bigcrimping/cistercian_clock/README.md

# Cistercian Clock

github

I keep a list of project ideas I want to do, and fairly near the top it says "NEW CLOCK".
After reading about [Cistercian Numerals](https://en.wikipedia.org/wiki/Cistercian_numerals) I decided to make a clock which:

1) Shows the date and time in the least amount of digits
2) Acts as a way of training my brain to do repetitive maths (something I don't enjoy)

Watch on YouTube (https://youtu.be/COuOULkGAXk)

The design is a custom PCB based on a ESP32 and MAX6969 LED drivers in a 3D printed housing

# How to read the time

The Cistercian Numeral system uses one digit to be able to count up to 9999

cistercian

The clock has two digits, left and right. The goal was to use as much of the range of each digit as possible.

The right hand digit is counting up in seconds until it reaches 7200 which is 2 hours.

The left hand digit is counting up in 2 hour increments, 4380 sets of 2 hours in a year.

# Software Setup

To setup the ESP32, load MicroPython from https://micropython.org/download/

Copy `code/secrets.example.py` to `code/secrets.py` and fill in your WiFi details. `secrets.py` is gitignored so your password won't be committed.

Once loaded, put the `main.py` and `secrets.py` into the MicroPython environment.

You can change your timezone in the main.py using `TIMEZONE_OFFSET` (hours from UTC, e.g. `1` for CET or `5.5` for IST)

The clock re-syncs with NTP once a day, and if WiFi isn't available at power-up it keeps retrying every 5 minutes.

# Mechanical Build

To assemble the clock first put the button into the rear housing

1_button_in

Then insert the PCB into the rear housing

2_pcb_in

Insert the light guide and diffuser

3_front_panels

Attach with M2 screws

4_screws

# PCB Build

The PCB is a simple double-sided board. The Gerbers are in the relevant folder and should be easy to produce by any PCB vendor.
