bigcrimping/cistercian_clock/mech/back_body.3MF

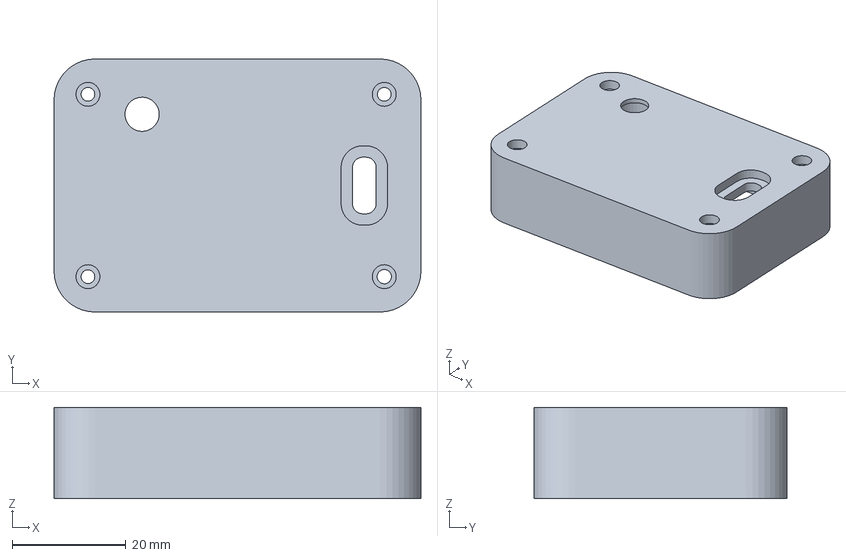
[picture p1: CAD file, 2026-03-03]
mech/back_body.3MF
64.4 x 44.4 x 16.0 mm
