bigcrimping/cistercian_clock/mech/button.3MF

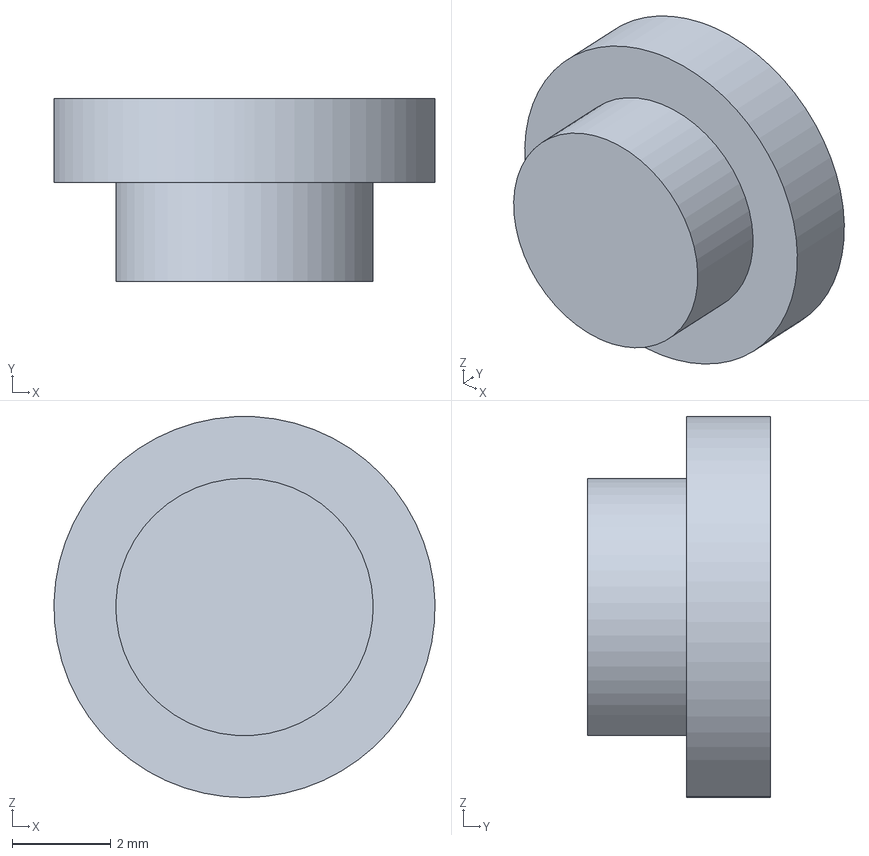
[picture p2: CAD file, 2026-03-03]
mech/button.3MF
7.70 x 3.70 x 7.70 mm
