bigcrimping/cistercian_clock/mech/light_guide.3MF

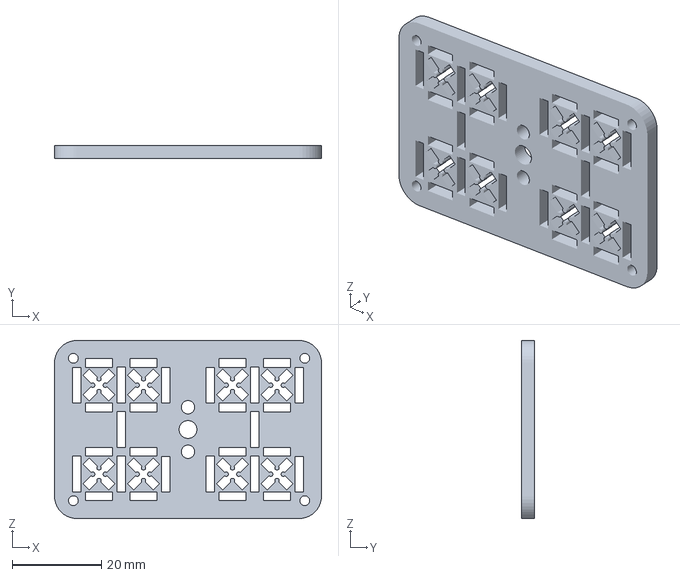
[picture p3: CAD file, 2026-03-03]
mech/light_guide.3MF
60.0 x 3.00 x 40.0 mm
