bigcrimping/cistercian_clock/mech/front_panel.3MF

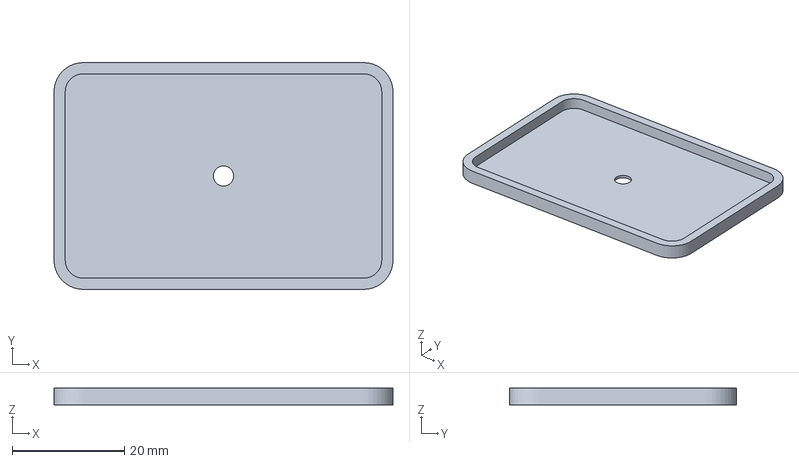
[picture p4: CAD file, 2026-03-03]
mech/front_panel.3MF
60.4 x 40.4 x 3.00 mm
