bigcrimping/cistercian_clock/pcb/assembly.pdf

DS53

DS31

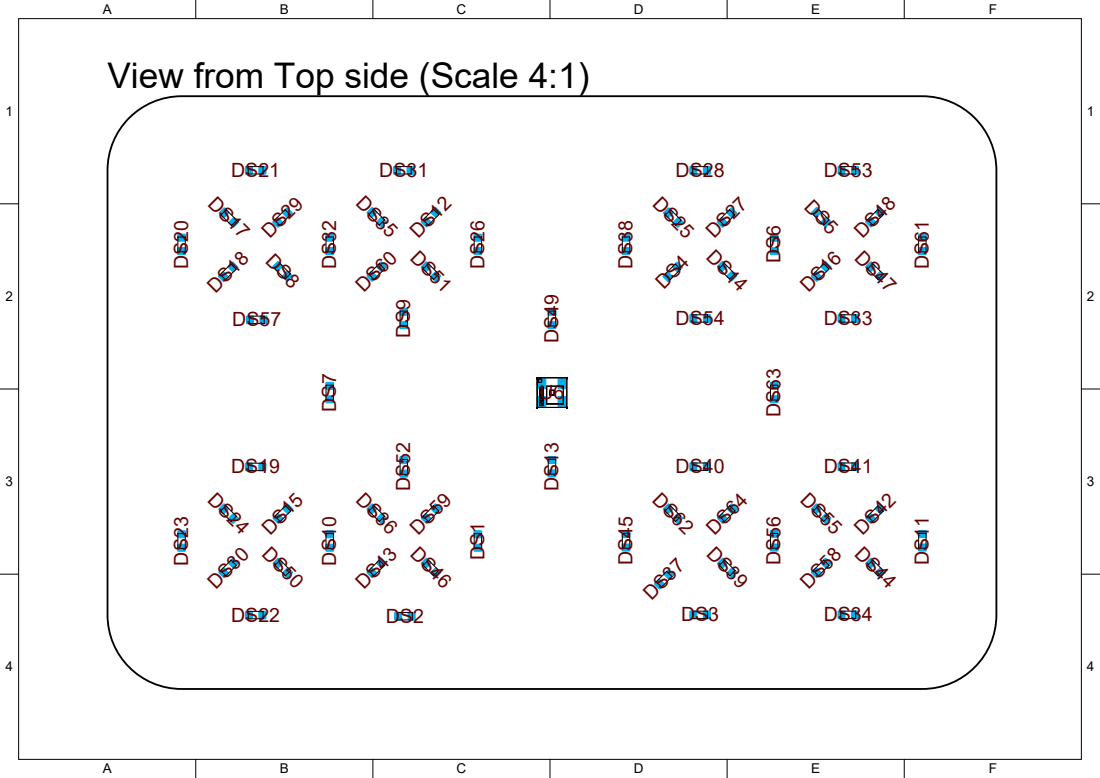
[picture p5: page 1]
DS3 DS¹

View from Top side (Scale 4:1)

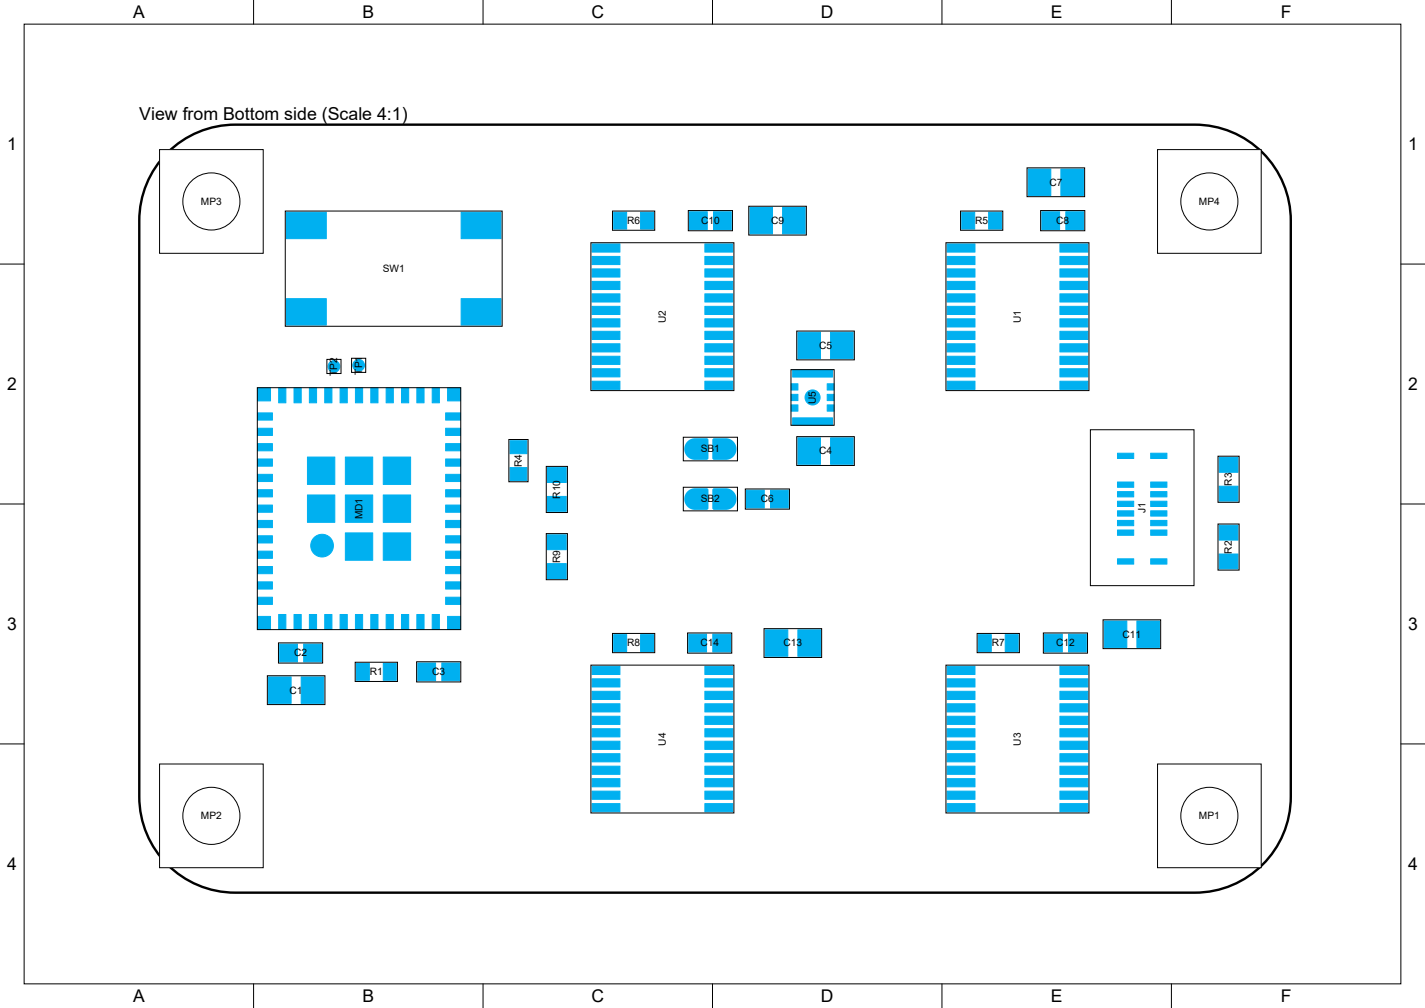
[picture p6: page 2]

View from Bottom side (Scale 4:1)

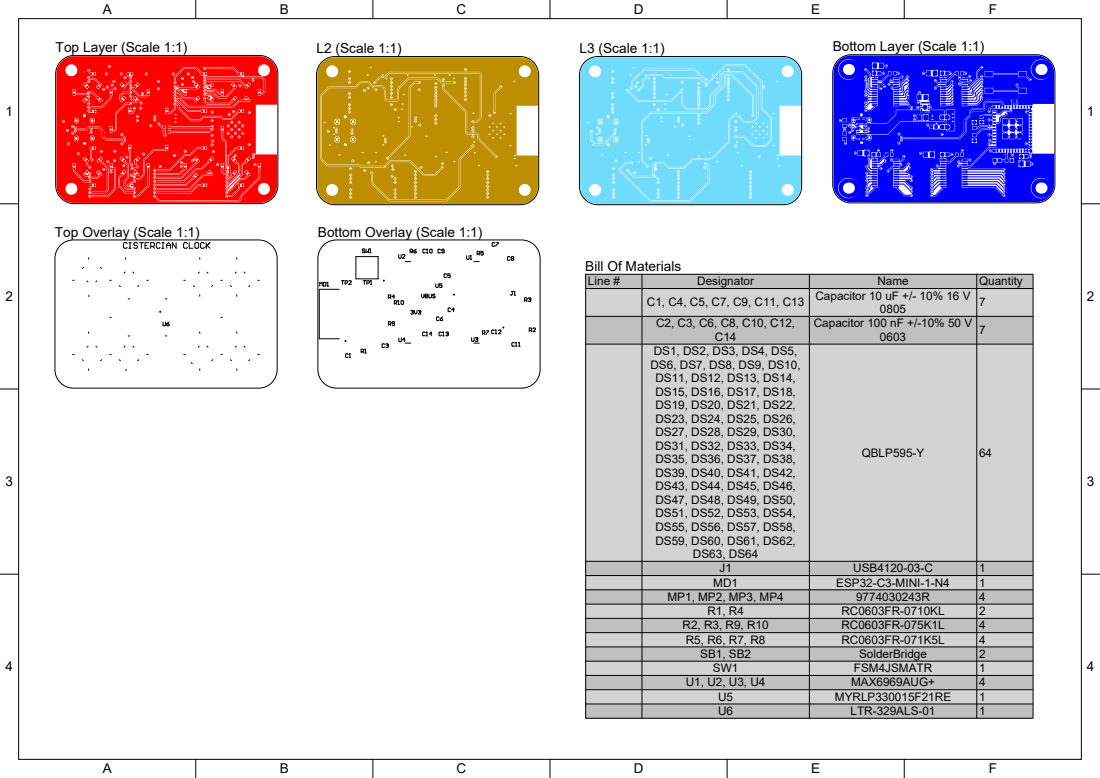
[picture p7: page 3]

Line # | Designator | Name | Quantity

C1, C4, C5, C7, C9, C11, C13 | Capacitor 10 uF +/- 10% 16 V 0805 | 7

C2, C3, C6, C8, C10, C12, C14 | Capacitor 100 nF +/-10% 50 V 0603 | 7

DS1, DS2, DS3, DS4, DS5, DS6, DS7, DS8, DS9, DS10, DS11, DS12, DS13, DS14, DS15, DS16, DS17, DS18, DS19, DS20, DS21, DS22, DS23, DS24, DS25, DS26, DS27, DS28, DS29, DS30, DS31, DS32, DS33, DS34, DS35, DS36, DS37, DS38, DS39, DS40, DS41, DS42, DS43, DS44, DS45, DS46, DS47, DS48, DS49, DS50, DS51, DS52, DS53, DS54, DS55, DS56, DS57, DS58, DS59, DS60, DS61, DS62, DS63, DS64 | QBLP595-Y | 64

J1 | USB4120-03-C | 1
MD1 | ESP32-C3-MINI-1-N4 | 1

R1, R4 | RC0603FR-0710KL | 2
R2, R3, R9, R10 | RC0603FR-075K1L | 4
R5, R6, R7, R8 | RC0603FR-071K5L | 4
SB1, SB2 | SolderBridge | 2
SW1 | FSM4JSMATR | 1
U1, U2, U3, U4 | MAX6969AUG+ | 4
U5 | MYRLP330015F21RE | 1
U6 | LTR-329ALS-01 | 1

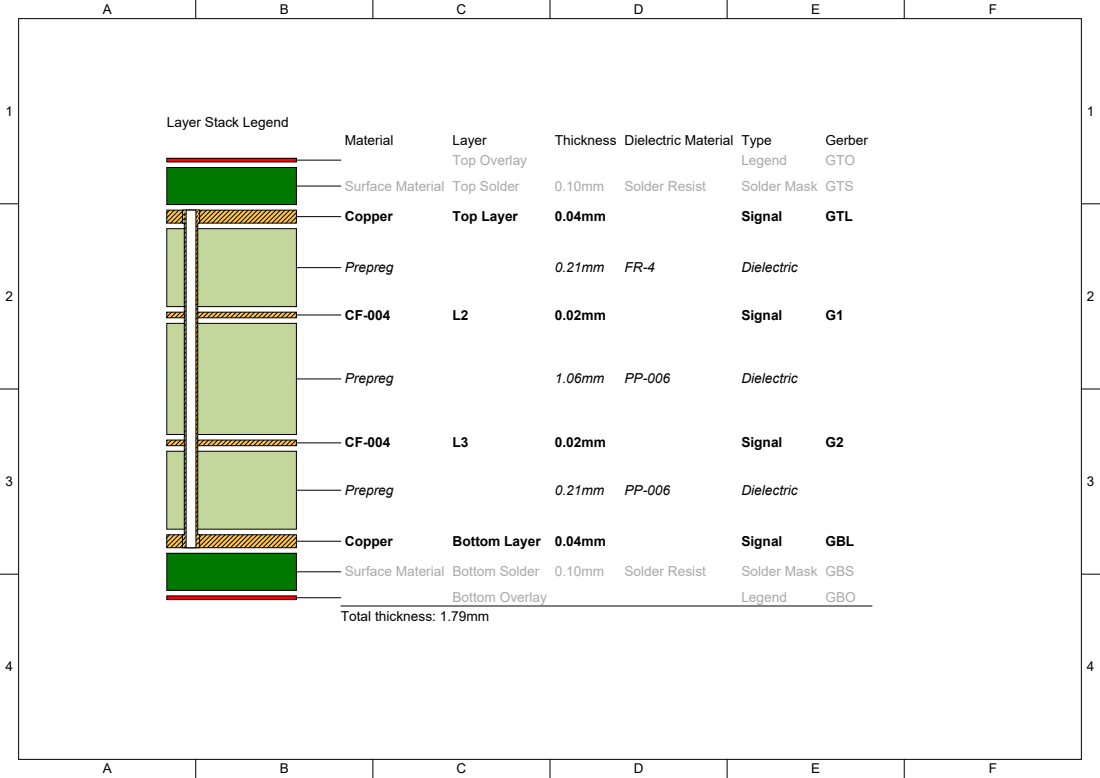
[picture p8: page 4]
Material; Layer; Thickness Dielectric Material Type; Gerber; Top Overlay; Legend; GTO; Surface Material Top Solder; Solder Resist; Solder Mask GTS; Copper; Top Layer; Signal; GTL; Prepreg; Dielectric; Bottom Layer 0.04mm; GBL; Surface Material Bottom Solder 0.10mm; Solder Mask GBS; Bottom Overlay; GBO; Total thickness: 1.79mm

Layer Stack Legend
