bigcrimping/cistercian_clock/pcb/Schematic.pdf

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
### U1_LED[15..0] U2_LED[15..0] U3_LED[15..0] U4_LED[15..0]

### U_ESP_Drivers ESP_Drivers.SchDoc U1_LED[15..0] U2_LED[15..0] U3_LED[15..0] U4_LED[15..0]

### U_LED LED.SchDoc

MP1

9774030243R

MP2

9774030243R

MP3

9774030243R

MP4

9774030243R

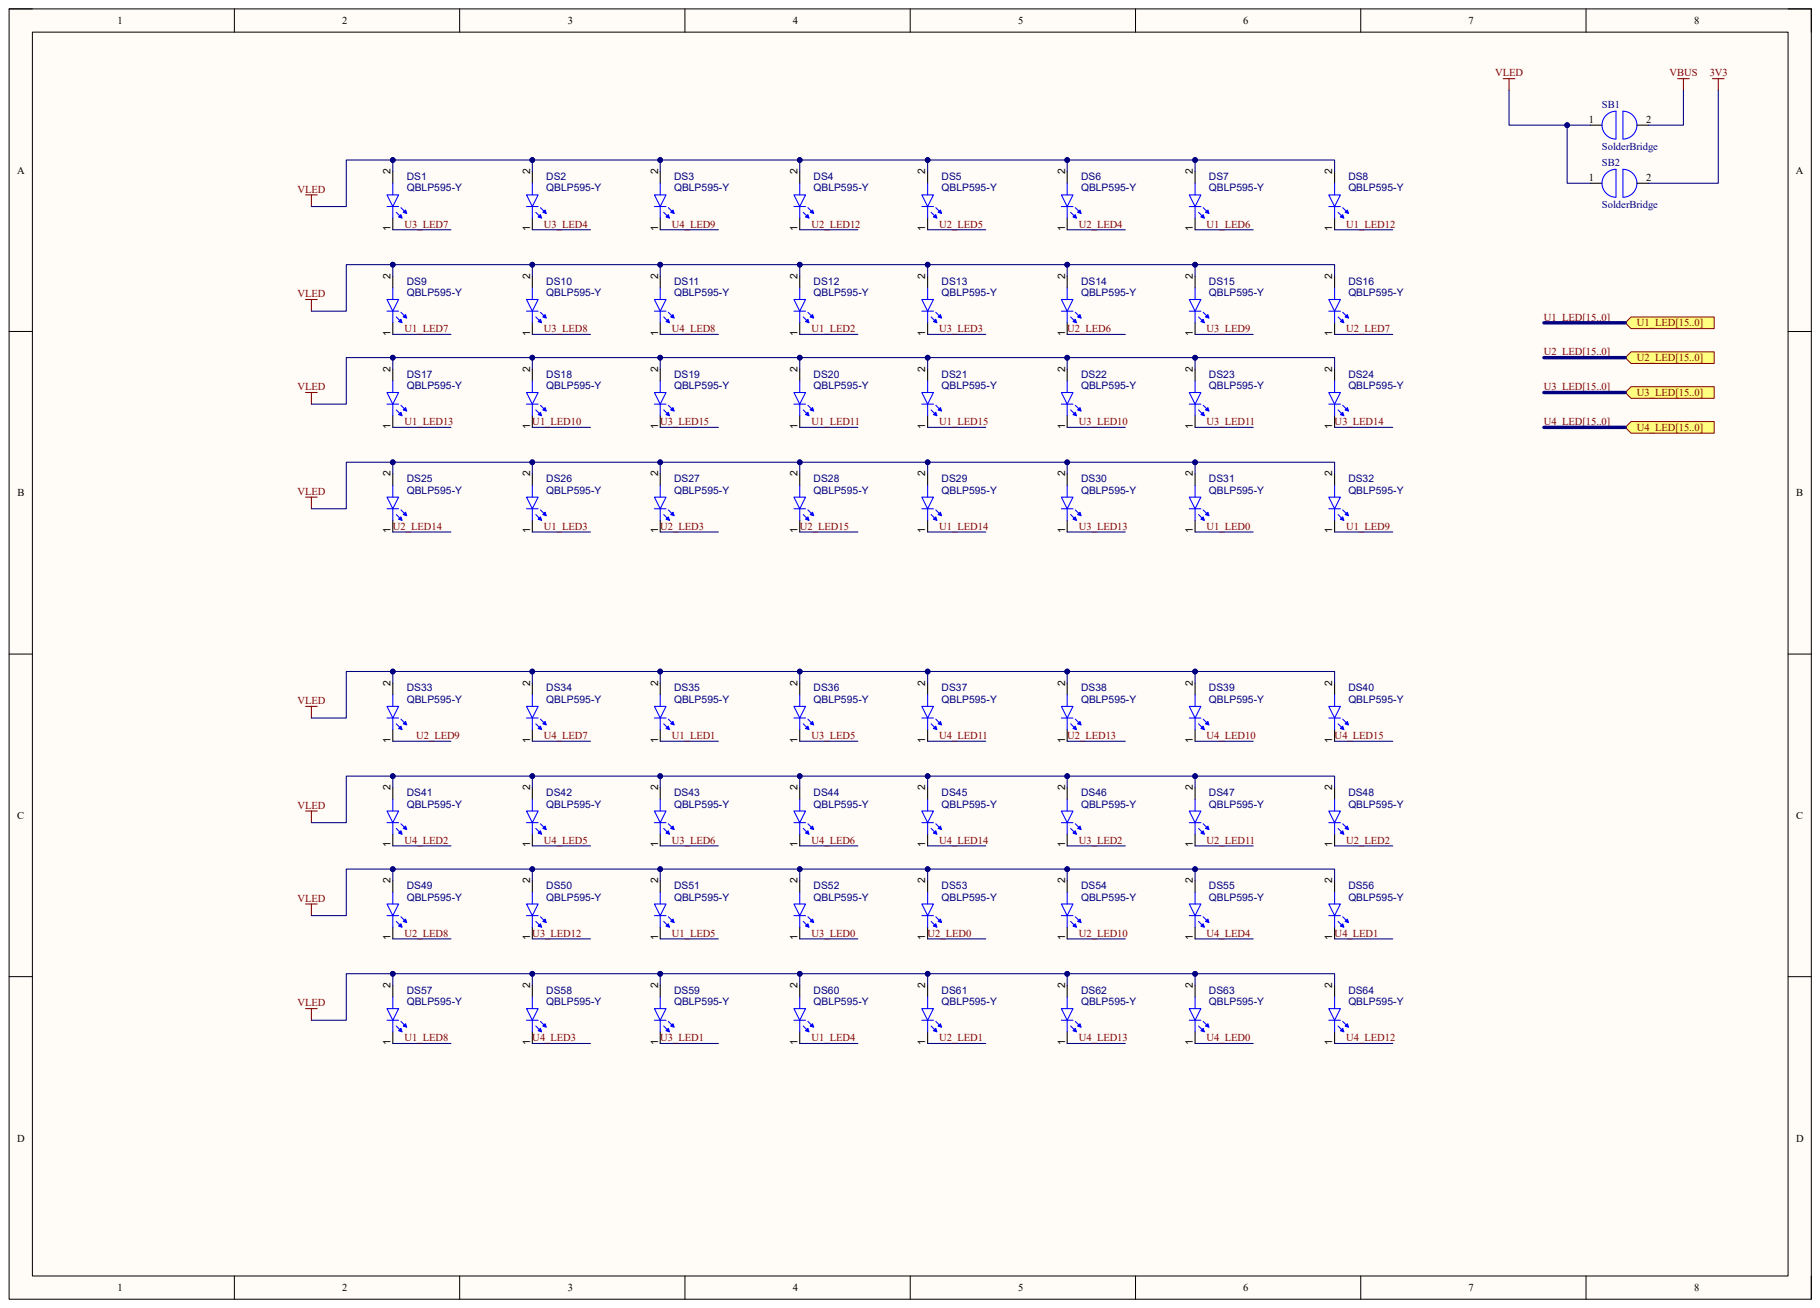
[picture p9: page 2]
QBLP595-Y; DS8 QBLP595-Y 2 1; DS16 QBLP595-Y 2 1; DS24 QBLP595-Y 2 1; DS32 QBLP595-Y 2 1; DS40 QBLP595-Y 2 1; DS48 QBLP595-Y 2 1; DS56 QBLP595-Y 2 1; DS64 QBLP595-Y; VLED; VBUS 3V3; U1_LED[15..0] U1_LED[15..0]; U2_LED[15..0] U2_LED[15..0]; U3_LED[15..0] U3_LED[15..0]; U4_LED[15..0] U4_LED[15..0]; SolderBridge; U1_LED2; U1_LED4; DS33 QBLP595-Y; U1_LED14; U1_LED12; U1_LED13; U1_LED11 U1_LED10; U1_LED15; U1_LED9; U1_LED8; U1_LED1; U1_LED0; U1_LED5; U1_LED3; U1_LED6; U1_LED7; U2_LED4; U2_LED14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

# VBUS 1 2

3V31 2

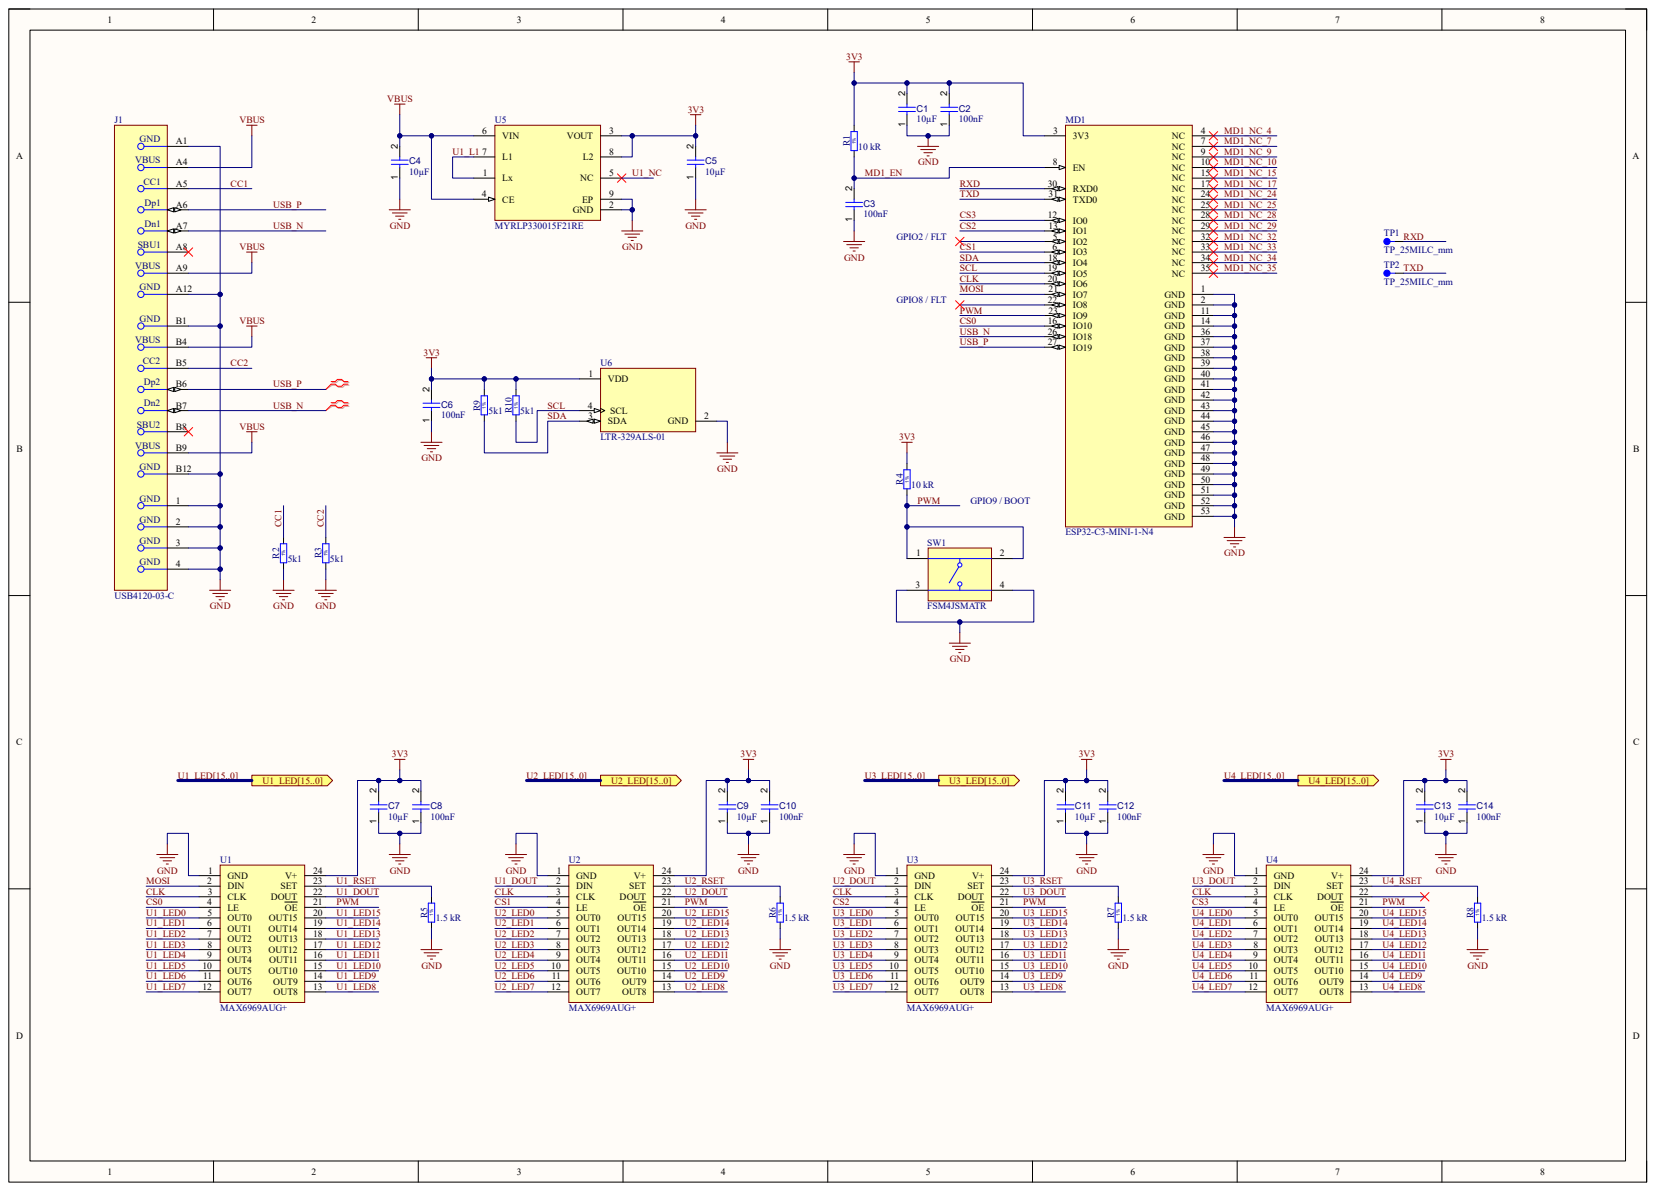
[picture p10: page 3]
