bigcrimping/cistercian_clock/code/secrets.example.py

SSID = "YOUR_WIFI_SSID"
PASSWORD = "YOUR_WIFI_PASSWORD"

# You can use a single string or a list/tuple of servers.
# The code will try each server (and retry each one) until one works.
NTP_SERVER = (
    "pool.ntp.org",
    "time.google.com",
    "time.cloudflare.com",
)
