bigcrimping/cistercian_clock/(commit log)

2026-03-03 Initialize README with project details and setup
    Added detailed project description, setup instructions, and assembly steps for the Cistercian Clock.
2026-03-03 Added PCB, code and mech files
    [back_body.3MF, button.3MF, front_panel.3MF, light_guide.3MF]
2026-11-13 Update to code behaviour
    Correct time, display and brightness errors
    - If the WiFi or NTP connection fails when you apply power, try
    again each 5 minutes. Before this change, the clock did not show
    the time until you removed and applied power again.
    - Set the clock time from NTP again each 24 hours. This keeps the
    time correct.
    - Show the seconds digit as the number of seconds (0 to 7199). This
    agrees with the README.
    - Start the display at full brightness. The OE signal is active-low,
    thus a low PWM duty gives a bright display.
    - If the light sensor is not available, set full brightness. Before
    this change, the display was almost off.
    - Read the four LTR-329 data registers in o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
    [main.py, secrets.example.py]
